menduhkesici/Solar-Tracking-System/Project Photo.JPG

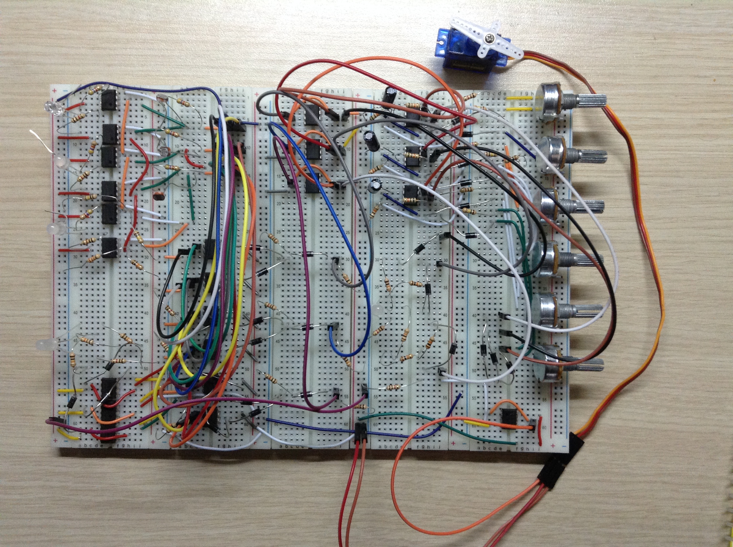
Project Photo.JPG
