menduhkesici/Solar-Tracking-System/README.md

# Solar Tracking System

The report, schematic, and photo of the term project "Solar Tracking System".
