menduhkesici/Solar-Tracking-System/Project Schematic.asc

C1: cap; 0.1µ
C2: cap; 0.1µ
C3: cap; 0.1µ
D1: diode
D2: diode
D3: diode
D4: diode
D5: diode
D6: diode
D7: diode
D8: diode
D9: diode
D10: diode
D11: diode
D12: diode
D13: diode
D14: diode
D15: diode
D16: diode
D17: diode
D18: diode
D19: diode
D20: diode
D21: diode
D22: diode
D23: diode
D24: diode
D25: diode
D26: diode
D27: diode
D28: diode
D29: diode
D30: diode
LDR_Left: res
LDR_Middle: res
LDR_Right: res
R1: res; 4.7k
R2: res; 6.7k
R3: res; 183k
R4: res; 4.7k
R5: res; 51k
R6: res; 4.7k
R7: res; 51k
R8: res; 8.3k
R9: res; 161k
R10: res; 51k
R11: res; 51k
R12: res; 13.4k
R13: res; 153.2k
R14: res; 51k
R15: res; 51k
R16: res; 10k
R17: res; 1k
R18: res; 1k
R19: res; 1k
R20: res; 10k
R21: res; 10k
R22: res; 1k
R23: res; 1k
R24: res; 10k
R25: res; 1k
R26: res; 10k
R28: res; 30k
R30: res; 10k
R32: res; 1k
R33: res; 1k
R34: res; 1k
R44: res; 10k
R46: res; 51k
R47: res; 1k
R48: res; 1k
R51: res; 4.7k
R52: res; 4.7k
R53: res; 1k
R55: res; 4.7k
U1: UniversalOpamp2
U2: UniversalOpamp2
U3: UniversalOpamp2
U4: UniversalOpamp2
U5: UniversalOpamp2
U6: UniversalOpamp2
U7: UniversalOpamp2
U8: UniversalOpamp2
U9: UniversalOpamp2
U10: UniversalOpamp2
U11: UniversalOpamp2
U12: UniversalOpamp2
U13: UniversalOpamp2
U14: UniversalOpamp2
U15: UniversalOpamp2
U16: UniversalOpamp2
U17: UniversalOpamp2
U18: UniversalOpamp2
U19: UniversalOpamp2
U20: UniversalOpamp2
U21: UniversalOpamp2
U22: UniversalOpamp2
U23: UniversalOpamp2
U24: UniversalOpamp2
U25: UniversalOpamp2
U26: UniversalOpamp2
U27: UniversalOpamp2
U28: UniversalOpamp2
V2: voltage; 6V
V3: voltage; 6V
Named nets: V_Left, V_Middle, V_Right, 0, Vx_Buffered, Vy_Buffered, Vz_Buffered, PWM_30, PWM_90, PWM_150, Vx, Vy, Vz, +6V, -6V, Motor_Input, RGB_4_Blue, RGB_4_Green, RGB_4_Ground, +4V, V_Left1, V_Left2, V_Middle1, V_Middle2, V_Right1, V_Right2, Va_Buffered, Vb_Buffered, Vc_Buffered, RGB_5_Blue, RGB_5_Green, RGB_5_Ground, RGB_1_Red, RGB_1_Green, RGB_1_Ground, RGB_2_Red, RGB_2_Green, RGB_2_Ground, RGB_3_Red, RGB_3_Green, RGB_3_Ground, +2.4V, RGB_4_Red, Va, Vb, Vc, RGB_5_Red, Motor_Input_Buffered
RGB_1: Common Anode RGB
RGB_2: Common Anode RGB
RGB_3: Common Anode RGB
RGB_5: Common Cathode RGB
RGB_4: Common Cathode RGB
